AI6YP/kicad/helix/helix433.stl

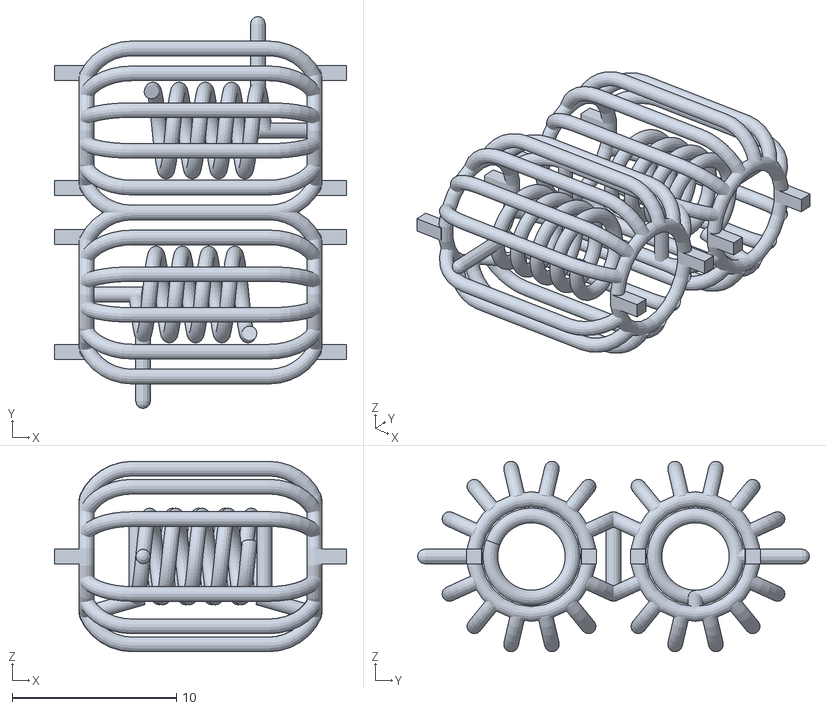
[picture p1: CAD file, 2018-10-19, last stored version]
helix/helix433.stl
17.8 x 23.9 x 11.6
