AI6YP/kicad/t200.stl

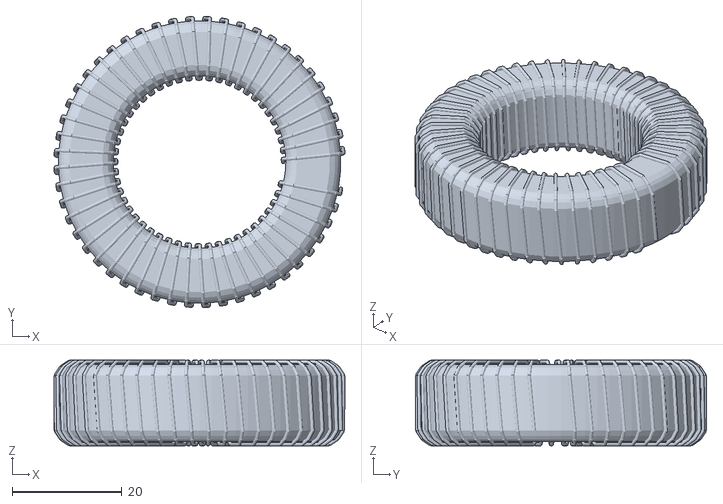
[picture p2: CAD file, 2017-10-15, last stored version]
t200.stl
53.0 x 53.0 x 15.6
