AI6YP/kicad/coil.stl

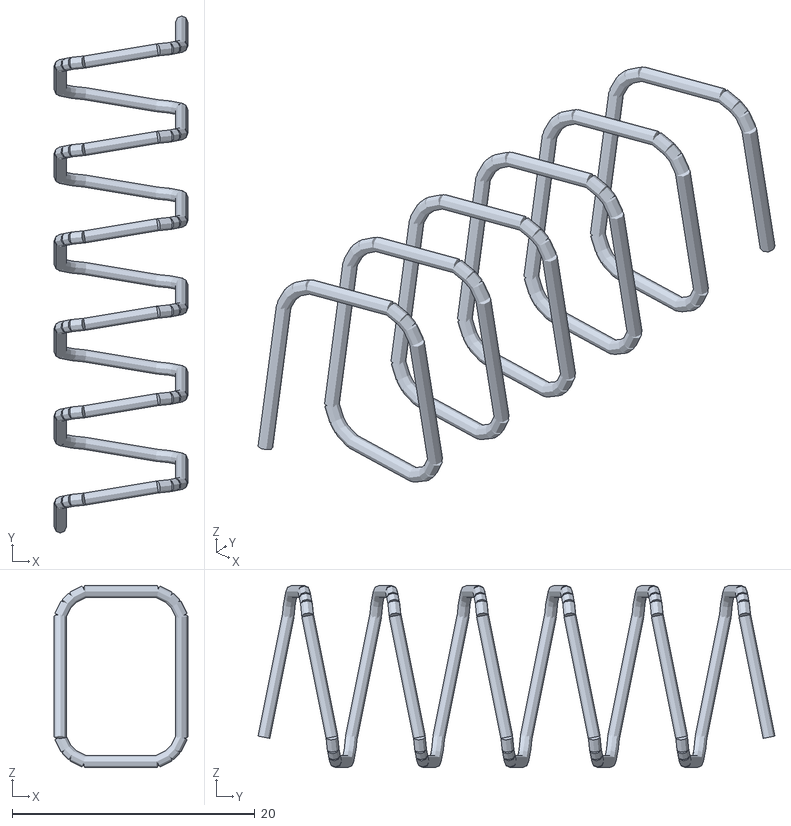
[picture p3: CAD file, 2017-10-14, last stored version]
coil.stl
11.0 x 42.6 x 15.0
