AI6YP/kicad/helix/helix6.stl

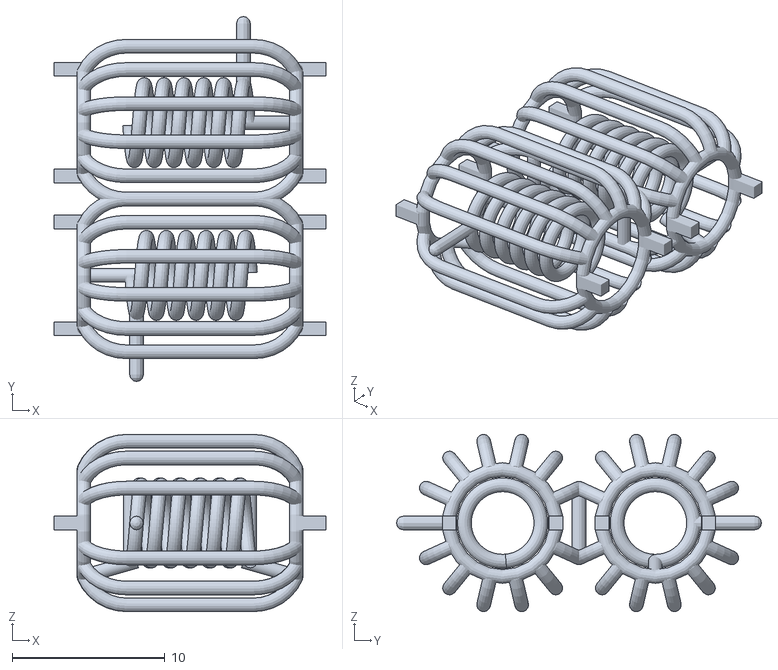
[picture p4: CAD file, 2018-10-19, last stored version]
helix/helix6.stl
17.8 x 23.9 x 11.6
