AI6YP/kicad/l-pcb.stl

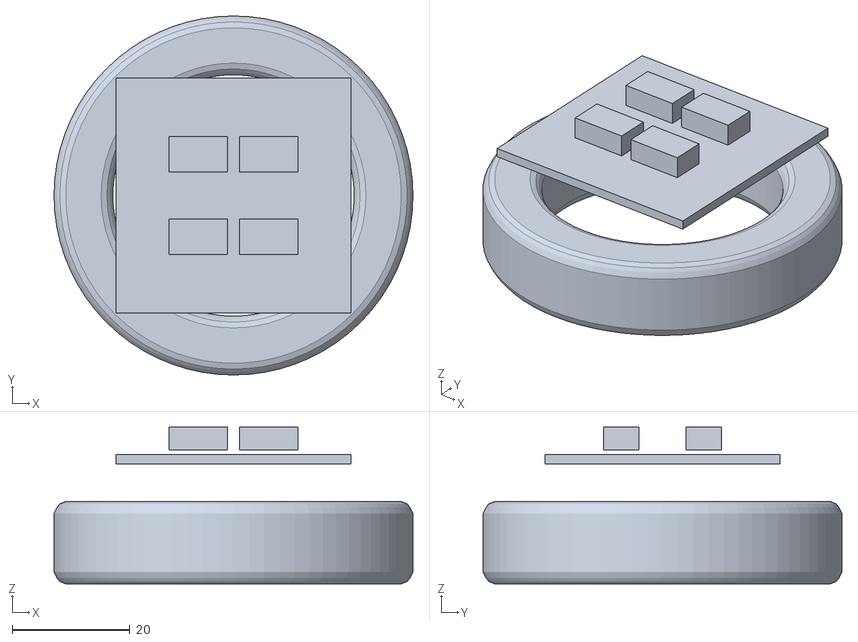
[picture p5: CAD file, 2017-10-12, last stored version]
l-pcb.stl
61.0 x 61.0 x 26.6
