AI6YP/kicad/helix/helix5.stl

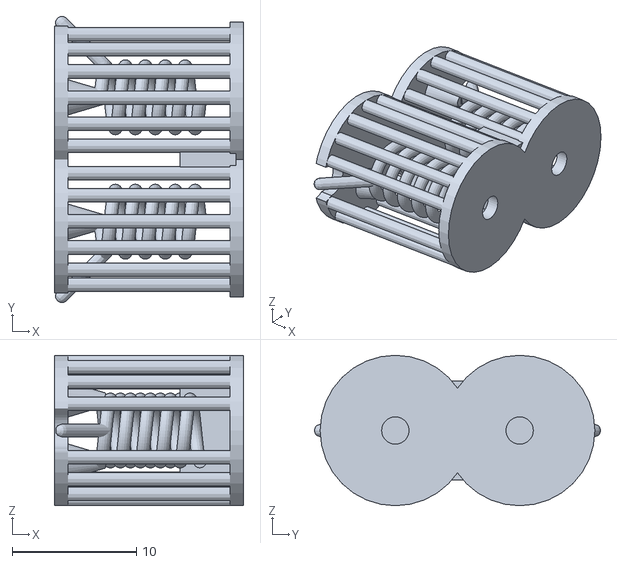
[picture p6: CAD file, 2018-01-15, last stored version]
helix/helix5.stl
15.2 x 23.0 x 12.1
