AI6YP/kicad/helix/helix4.stl

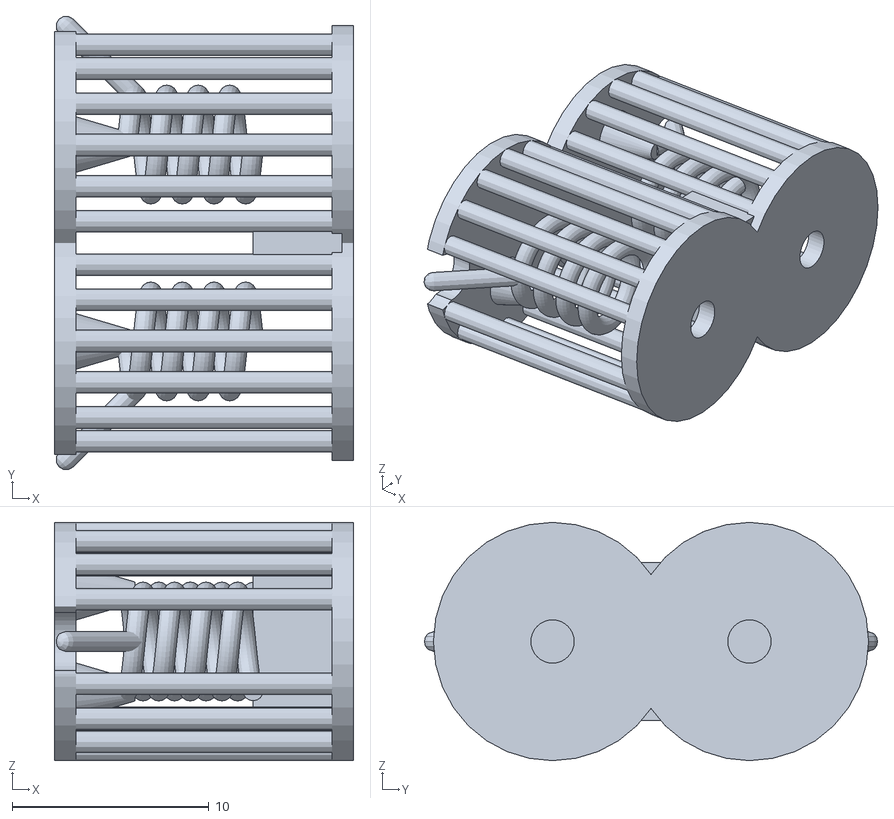
[picture p7: CAD file, 2018-01-15, last stored version]
helix/helix4.stl
15.2 x 23.0 x 12.1
