AI6YP/kicad/(list of files, cad)

Other CAD files:
helix/helix433a.stl
helix/helix6a.stl
helix/helix4-75.stl
helix/helix.stl
l-pcb.amf
tokamak/l-pcb.amf
