AI6YP/kicad/mitsu/mitsu.kicad_pcb

## KiCad design mitsu/mitsu.kicad_pcb (2018-10-19, last stored version)

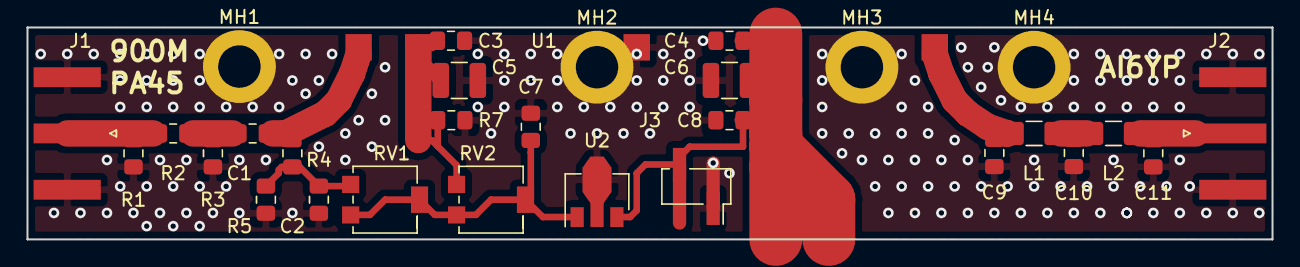
[picture p8: board mitsu.kicad_pcb from above]

Board: 2 copper layers, 94.0 x 16.0 mm, 30 parts (0 on the bottom side), 11 nets.

Parts:
C1: 1000; C_0805_2012Metric_Pad1.15x1.40mm_HandSolder
C2, C3, C4: 4700; C_0805_2012Metric_Pad1.15x1.40mm_HandSolder
C5, C6: 22.0; C_1210_3225Metric
C7, C8: 0.1; C_0805_2012Metric_Pad1.15x1.40mm_HandSolder
C9, C11: 4.7; C_0805_2012Metric_Pad1.15x1.40mm_HandSolder
C10: 7.5; C_0805_2012Metric_Pad1.15x1.40mm_HandSolder
J1, J2: Conn_Coaxial; SMA_Amphenol_132289_EdgeMount
J3: Conn_01x04_Male; PinHeader_1x02_P2.54mm_Vertical_SMD_Pin1Right
L1, L2: 11u; L_1206_3216Metric
MH1, MH2, MH3, MH4: MountingHole; MountingHole_3.2mm_M3_ISO14580_Pad
R1, R3: 300; R_0805_2012Metric_Pad1.15x1.40mm_HandSolder
R2: 18; R_0805_2012Metric_Pad1.15x1.40mm_HandSolder
R4: 15k; R_0805_2012Metric_Pad1.15x1.40mm_HandSolder
R5, R7: 470; R_0805_2012Metric_Pad1.15x1.40mm_HandSolder
RV1, RV2: 500; Potentiometer_Bourns_3214G_Horizontal
U1: MPA
U2: L78L06_SOT89; SOT-89-3

Connections:
+12V: C4.2, C6.2, C8.1, J3.2, U1.3, U2.3
GNDPWR: C2.2, C3.2, C4.1, C5.2, C6.1, C7.2, C8.2, C9.1, C10.1, C11.1, J1.2, J2.2, J3.1, MH1.1, MH2.1, MH3.1, MH4.1, R1.2, R3.2, R5.1, R7.2, U1.5, U2.2
unnamed: C1.1, R4.1, U1.1
unnamed: C1.2, R2.1, R3.1
unnamed: C2.1, R4.2, R5.2, RV1.3
unnamed: C3.1, C5.1, R7.1, RV2.3, U1.2
unnamed: C7.1, RV1.1, RV1.2, RV2.1, RV2.2, U2.1
unnamed: C9.2, L1.1, U1.4
unnamed: C10.2, L1.2, L2.1
unnamed: C11.2, J2.1, L2.2
unnamed: J1.1, R1.1, R2.2
