AI6YP/kicad/fluxcapacitor/fluxcapacitor.kicad_pcb

## KiCad design fluxcapacitor/fluxcapacitor.kicad_pcb (2017-10-19, last stored version)

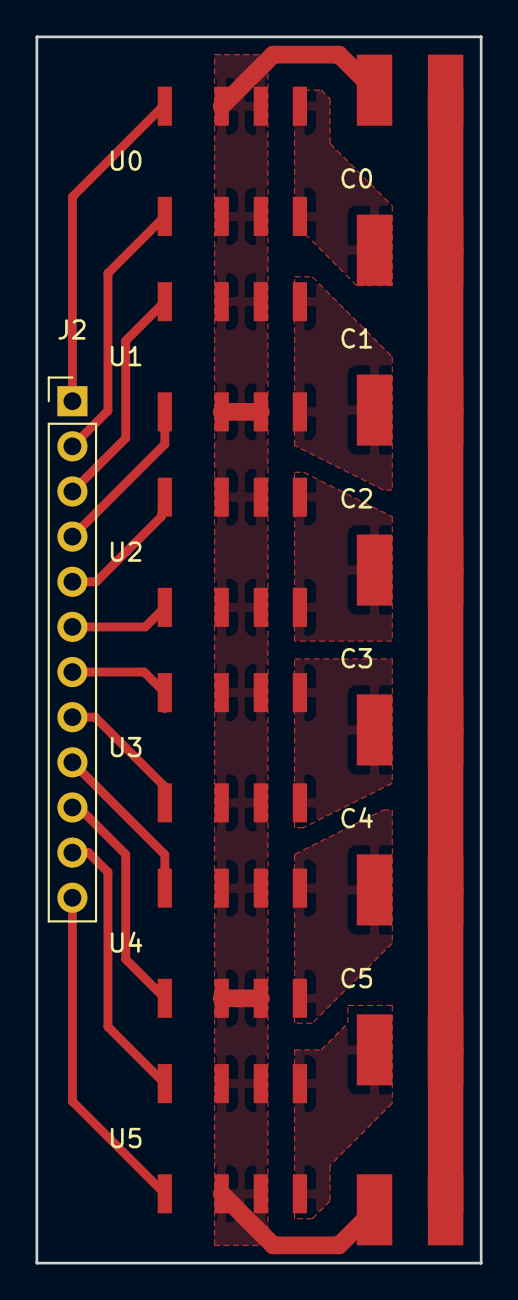
[picture p9: board fluxcapacitor.kicad_pcb from above]

Board: 2 copper layers, 25.0 x 69.0 mm, 15 parts (0 on the bottom side), 20 nets.

Parts:
C0, C1, C2, C3, C4, C5, C100, C101: C; C_1111
J2: Conn_01x12; Pin_Header_Straight_1x12_Pitch2.54mm
U0, U1, U2, U3, U4, U5: IM_Relay_Bis; IM_Relay_Gul_Wings

Connections:
B: C100.2, C101.2, U0.2, U0.3, U0.6, U0.7, U1.2, U1.3, U1.6, U1.7, U2.2, U2.3, U2.6, U2.7, U3.2, U3.3, U3.6, U3.7, U4.2, U4.3, U4.6, U4.7, U5.2, U5.3, U5.6, U5.7
unnamed: C0.1, C1.1, C2.1, C3.1, C4.1, C5.1, C100.1, C101.1
unnamed: C0.2, U0.4, U0.5
unnamed: C1.2, U1.4, U1.5
unnamed: C2.2, U2.4, U2.5
unnamed: C3.2, U3.4, U3.5
unnamed: C4.2, U4.4, U4.5
unnamed: C5.2, U5.4, U5.5
unnamed: J2.1, U0.8
unnamed: J2.2, U0.1
unnamed: J2.3, U1.8
unnamed: J2.4, U1.1
unnamed: J2.5, U2.8
unnamed: J2.6, U2.1
unnamed: J2.7, U3.8
unnamed: J2.8, U3.1
unnamed: J2.9, U4.8
unnamed: J2.10, U4.1
unnamed: J2.11, U5.8
unnamed: J2.12, U5.1
