AI6YP/kicad/(commit log)

2017-10-12 added stl, amf version
    [l-pcb.amf, l-pcb.stl]
2017-10-14 updated coil + STL
    [coil.stl]
2017-10-15 added winded toroid coil model
    [t200.stl]
2017-10-18 L pcb svg update
2017-10-18 L16 v1
    [tokamak.kicad_pcb, tokamak.sch]
2017-10-19 added flux capacitor v1
    [fluxcapacitor.kicad_pcb, fluxcapacitor.sch]
2017-10-25 moved 3d models into tokamak folder
    [l-pcb.stl]
2017-10-25 moved 3d model of coil into tokamak folder
    [coil.stl]
2018-01-02 added helix code
    [helix.stl]
2018-01-04 helix improvements
    [helix.stl]
2018-01-07 915MHz version
    [helix.stl]
2018-01-15 new version of helix
    [helix.stl, helix4-75.stl]
2018-01-15 fixed helix5
    [helix5.stl]
2018-01-15 updated helix generator to fix shapeways issues
    [helix4-75.stl, helix4.stl, helix5.stl]
2018-03-05 more filters
2018-03-08 initial helix board
    [smaHelix.kicad_pcb, smaHelix.sch]
2018-04-28 started 3 stage filter
2018-04-30 new version of helix filter
2018-09-18 added mitsubishi board
    [mitsu.kicad_pcb, mitsu.sch]
2018-09-18 fixed PA footprint
    [mitsu.kicad_pcb, mitsu.sch]
2018-10-19 helix v6
    [helix433.stl, helix433a.stl, helix6.stl, helix6a.stl]
2018-10-19 final changes for mitsu v1
    [mitsu.kicad_pcb, mitsu.sch]
2024-01-08 initial components for Kicad 7 library
2025-01-01 TV frame 3D model
2025-06-15 current state of library
